DominikVoigt/esp32-weightsensor/docs/Case-STL (Demo Version)/Weightsensor - Top Mount Plate.stl

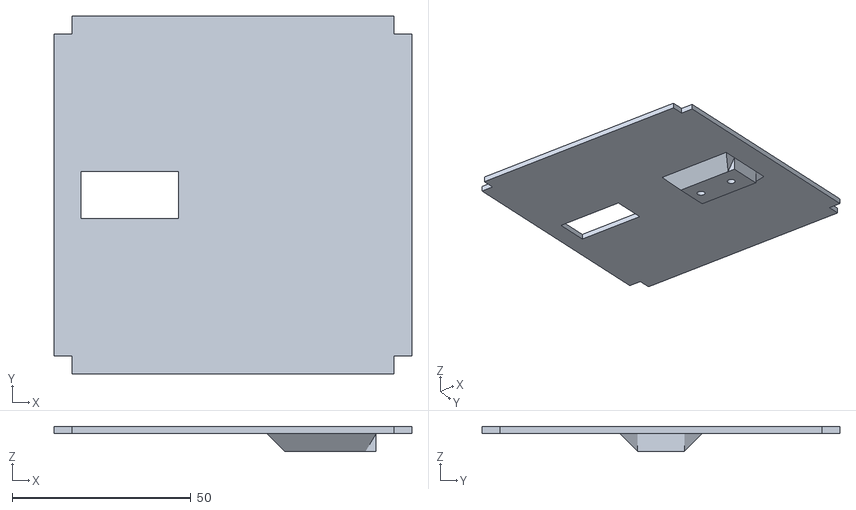
[picture p2: CAD file, 2023-10-16]
docs/Case-STL (Demo Version)/Weightsensor - Top Mount Plate.stl
100.0 x 100.0 x 7.00
