DominikVoigt/esp32-weightsensor/docs/Updated Case-STL/Weightsensor - Top Plate.stl

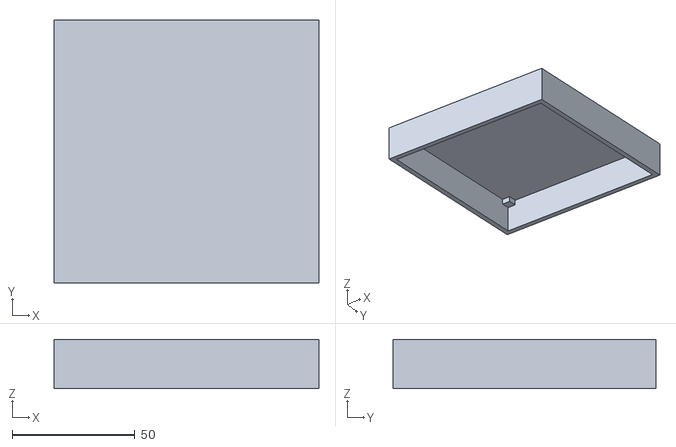
[picture p3: CAD file, 2023-10-20]
docs/Updated Case-STL/Weightsensor - Top Plate.stl
108.0 x 107.0 x 20.0
