DominikVoigt/esp32-weightsensor/docs/Case-STL (Demo Version)/Weightsensor - Top.stl

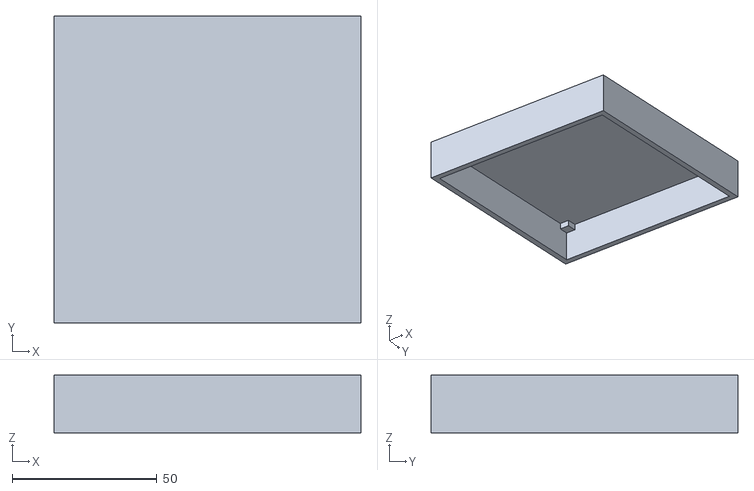
[picture p4: CAD file, 2023-10-16]
docs/Case-STL (Demo Version)/Weightsensor - Top.stl
106.0 x 106.0 x 20.0
