DominikVoigt/esp32-weightsensor/docs/Updated Case-STL/Weightsensor - Bottom.stl

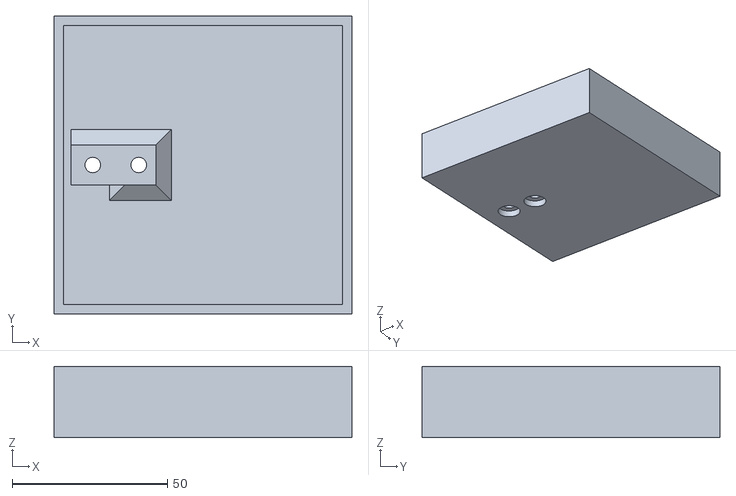
[picture p5: CAD file, 2023-10-20]
docs/Updated Case-STL/Weightsensor - Bottom.stl
96.0 x 96.0 x 23.0
