DominikVoigt/esp32-weightsensor/docs/Case-STL (Demo Version)/Weightsensor - Offset to Groud.stl

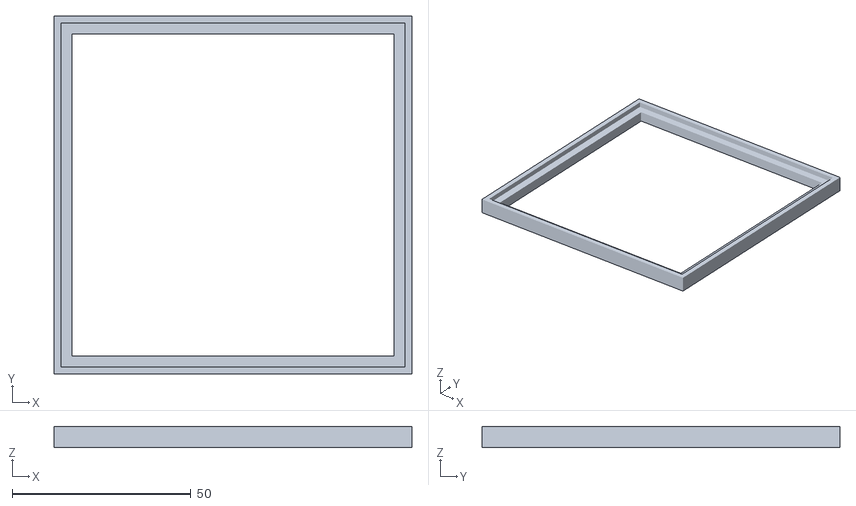
[picture p6: CAD file, 2023-10-16]
docs/Case-STL (Demo Version)/Weightsensor - Offset to Groud.stl
100.0 x 100.0 x 6.00
