DominikVoigt/esp32-weightsensor/docs/Updated Case-STL/Weightsensor - Bottom Offset.stl

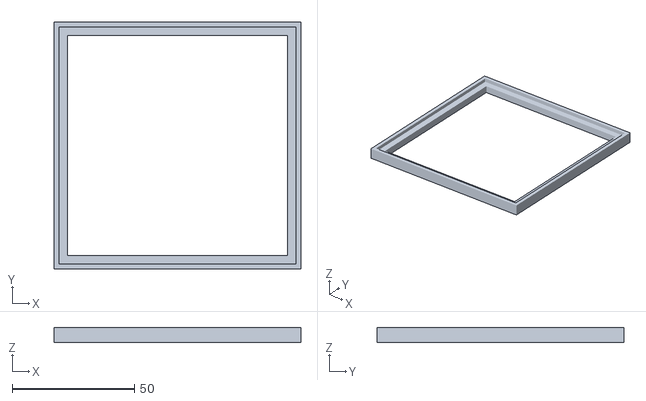
[picture p7: CAD file, 2023-10-20]
docs/Updated Case-STL/Weightsensor - Bottom Offset.stl
101.0 x 101.0 x 6.00
