DominikVoigt/esp32-weightsensor/docs/Updated Case-STL/Weightsensor - Top Mount Plate.stl

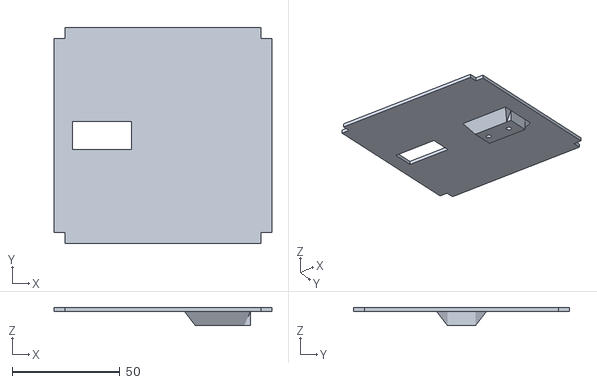
[picture p8: CAD file, 2023-10-20]
docs/Updated Case-STL/Weightsensor - Top Mount Plate.stl
101.0 x 100.0 x 8.50
