DominikVoigt/esp32-weightsensor/(list of files, cad)

Other CAD files:
docs/Case-STL (Demo Version)/Weightsensor - Bottom.stl
