DominikVoigt/esp32-weightsensor/src/calibrate.cpp

/*
   This example file shows how to calibrate the load cell and optionally store the calibration
   value in EEPROM, and also how to change the value manually.
   The result value can then later be included in your project sketch or fetched from EEPROM.
*/

#include <HX711_ADC.h>
#include <EEPROM.h>
#include <SPI.h>

// pins:
const int HX711_dout = 4; // mcu > HX711 dout pin
const int HX711_sck = 16; // mcu > HX711 sck pin

// HX711 constructor:
HX711_ADC LoadCell(HX711_dout, HX711_sck);

const int calVal_eepromAdress = 0;
unsigned long t = 0;

void calibrate()
{
  Serial.println("***");
  Serial.println("Start calibration:");
  Serial.println("Place the load cell an a level stable surface.");
  Serial.println("Remove any load applied to the load cell.");
  Serial.println("Send 't' from serial monitor to set the tare offset.");

  boolean resume = false;
  while (!resume)
  {
    LoadCell.update();
    if (Serial.available() > 0)
    {
      if (Serial.available() > 0)
      {
        char inByte = Serial.read();
        if (inByte == 't')
          LoadCell.tareNoDelay();
      }
    }
    if (LoadCell.getTareStatus() == true)
    {
      Serial.println("Tare complete");
      resume = true;
    }
  }

  Serial.println("Now, place your known mass on the loadcell.");
  Serial.println("Then send the weight of this mass in grams (i.e. 100.0) from the serial monitor.");

  float known_mass = 0;
  resume = false;
  while (resume == false)
  {
    LoadCell.update();
    if (Serial.available() > 0)
    {
      known_mass = Serial.parseFloat();
      if (known_mass != 0)
      {
        Serial.print("Known mass is: ");
        Serial.println(known_mass);
        resume = true;
      }
    }
  }
  // refresh the dataset to be sure that the known mass is measured correct
  LoadCell.refreshDataSet();
  // get the new calibration value
  float newCalibrationValue = LoadCell.getNewCalibration(known_mass);

  Serial.print("New calibration value has been set to: ");
  Serial.print(newCalibrationValue);
  Serial.println(", use this as calibration value (calFactor) in your project sketch.");

  Serial.print("Save this value to EEPROM adress ");
  Serial.print(calVal_eepromAdress);
  Serial.println("? y/n");

  resume = false;
  while (!resume)
  {
    if (Serial.available() > 0)
    {
      char inByte = Serial.read();
      if (inByte == 'y')
      {
        EEPROM.begin(512);
        EEPROM.put(calVal_eepromAdress, newCalibrationValue);
        EEPROM.commit();
        EEPROM.get(calVal_eepromAdress, newCalibrationValue);
        Serial.print("Value ");
        Serial.print(newCalibrationValue);
        Serial.print(" saved to EEPROM address: ");
        Serial.println(calVal_eepromAdress);
        resume = true;
      }
      else if (inByte == 'n')
      {
        Serial.println("Value not saved to EEPROM");
        resume = true;
      }
    }
  }

  Serial.println("End calibration");
  Serial.println("***");
  Serial.println("To re-calibrate, send 'r' from serial monitor.");
  Serial.println("For manual edit of the calibration value, send 'c' from serial monitor.");
  Serial.println("***");
}

void setup()
{
  Serial.begin(9600);
  delay(10);
  Serial.println();
  Serial.println("Starting...");

  LoadCell.begin();
  unsigned long stabilizingtime = 2000; // preciscion right after power-up can be improved by adding a few seconds of stabilizing time
  boolean _tare = true;                 // set this to false if you don't want tare to be performed in the next step
  LoadCell.start(stabilizingtime, _tare);
  if (LoadCell.getTareTimeoutFlag() || LoadCell.getSignalTimeoutFlag())
  {
    Serial.println("Timeout, check MCU>HX711 wiring and pin designations");
    while (1)
      ;
  }
  else
  {
    LoadCell.setCalFactor(1.0); // user set calibration value (float), initial value 1.0 may be used for this sketch
    Serial.println("Startup is complete");
  }
  while (!LoadCell.update())
    ;
  calibrate(); // start calibration procedure
}

void loop()
{
  static boolean newDataReady = false;
  const int serialPrintInterval = 500; // increase value to slow down serial print activity

  // check for new data/start next conversion:
  if (LoadCell.update())
    newDataReady = true;

  // get smoothed value from the dataset:
  if (newDataReady)
  {
    if (millis() > t + serialPrintInterval)
    {
      float i = LoadCell.getData();
      Serial.print("Load_cell output val: ");
      Serial.println(i);
      newDataReady = 0;
      t = millis();
    }
  }

  // receive command from serial terminal
  if (Serial.available() > 0)
  {
    char inByte = Serial.read();
    if (inByte == 't')
      LoadCell.tareNoDelay(); // tare
    else if (inByte == 'r')
      calibrate(); // calibrate
  }

  // check if last tare operation is complete
  if (LoadCell.getTareStatus() == true)
  {
    Serial.println("Tare complete");
  }
}
