DominikVoigt/esp32-weightsensor/(commit log)

2023-10-16 Complete Project
    [Weightsensor - Bottom.stl, Weightsensor - Offset to Groud.stl, Weightsensor - Top Mount Plate.stl, Weightsensor - Top.stl]
2023-10-17 Fix small display bug
    [deploy.cpp]
2023-10-17 Adapt sensor id position
2023-10-20 Add demo GIF, update STL files
    [Weightsensor - Bottom Offset.stl, Weightsensor - Bottom.stl, Weightsensor - Offset to Groud.stl, Weightsensor - Top Mount Plate.stl, Weightsensor - Top Plate.stl, Weightsensor - Top.stl]
2024-01-31 add toggle to allow using weight sensor without mqtt
